ImEvwan/HellkiteOpenSource/-íontroller case/Footing.STEP

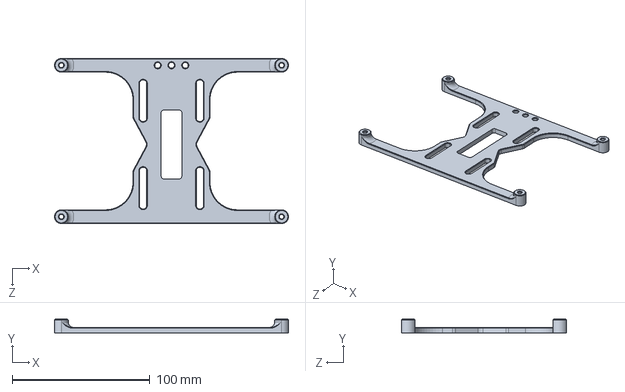
[picture p1: CAD file, 2023-02-28]
-íontroller case/Footing.STEP
170.0 x 10.0 x 120.0 mm
