ImEvwan/HellkiteOpenSource/Deck Protector/Track Protector.STEP

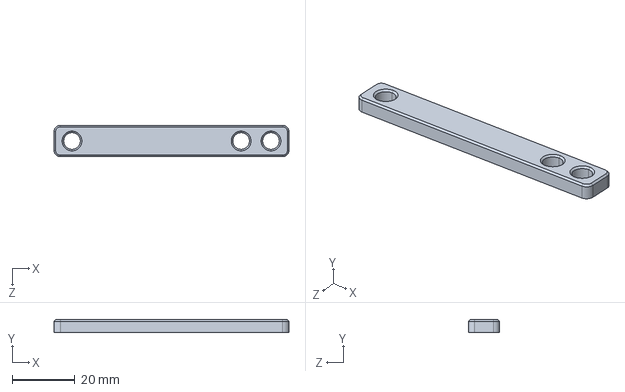
[picture p2: CAD file, 2023-02-28]
Deck Protector/Track Protector.STEP
75.0 x 4.00 x 10.0 mm
