ImEvwan/HellkiteOpenSource/Gear Drive/Drivin gear 19 T.pdf.stp

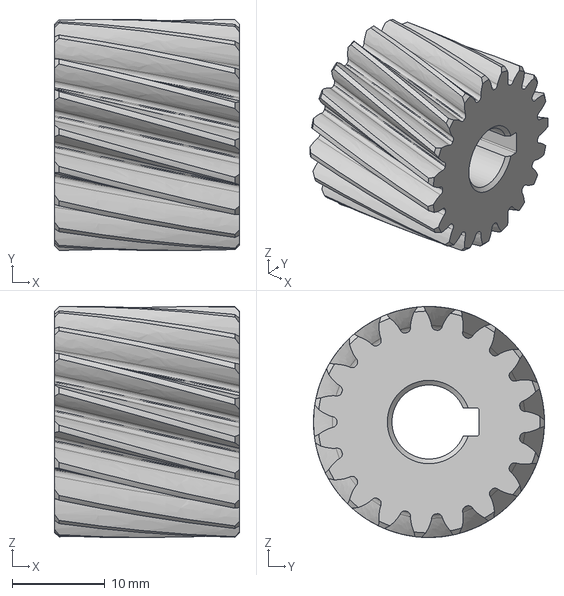
[picture p3: CAD file, 2023-02-28]
Gear Drive/Drivin gear 19 T.pdf.stp
20.0 x 25.0 x 25.0 mm
