ImEvwan/HellkiteOpenSource/Motor mount flipsky/Roller.STEP

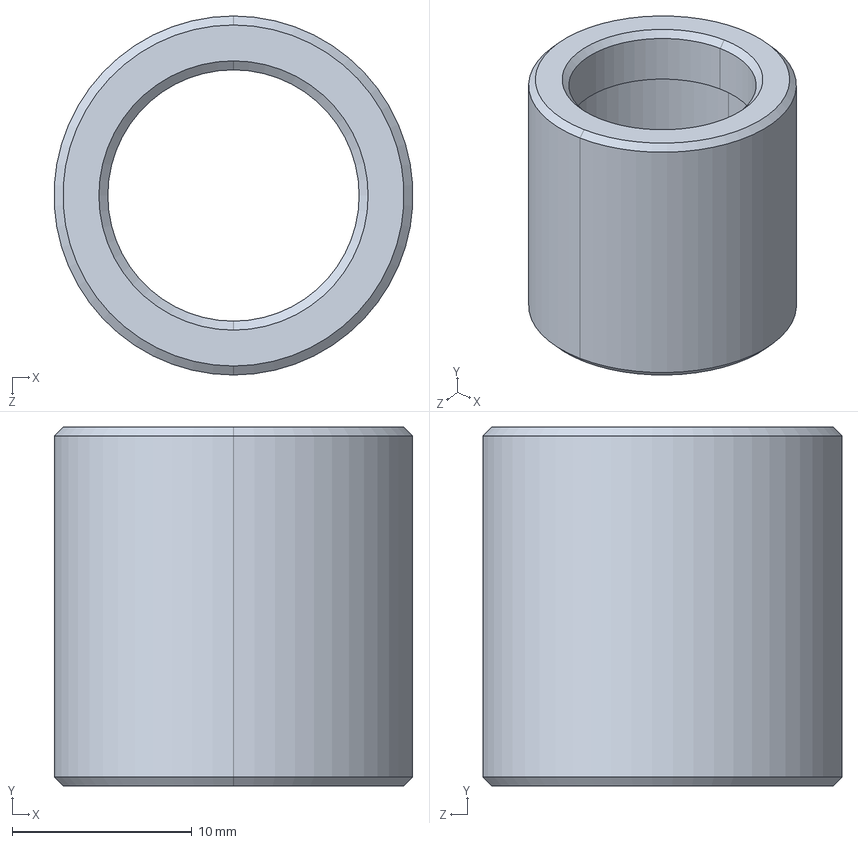
[picture p4: CAD file, 2023-02-28]
Motor mount flipsky/Roller.STEP
20.0 x 20.0 x 20.0 mm
