ImEvwan/HellkiteOpenSource/Motor mount MTB/Roller mount.STEP

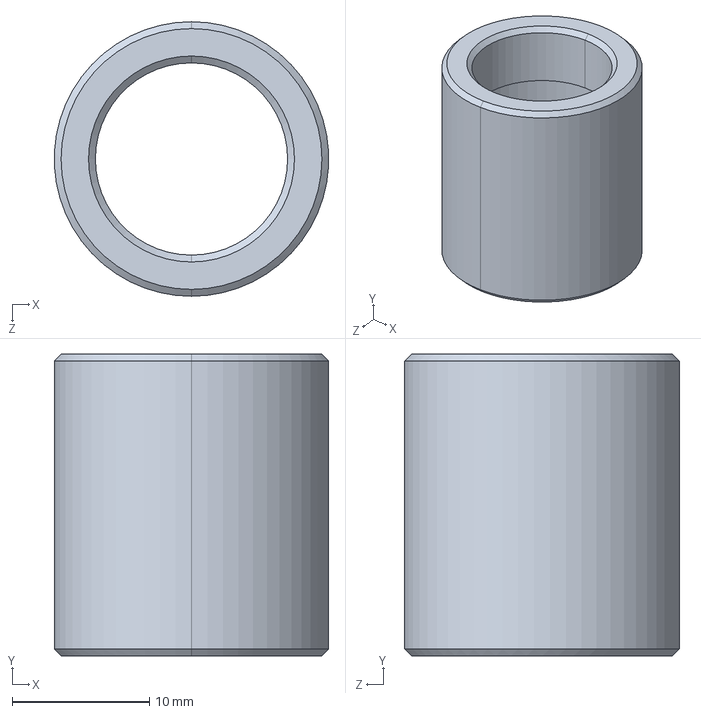
[picture p5: CAD file, 2023-02-28]
Motor mount MTB/Roller mount.STEP
20.0 x 22.0 x 20.0 mm
