ImEvwan/HellkiteOpenSource/Offroad MTB KIT 1/Bracket L.stp

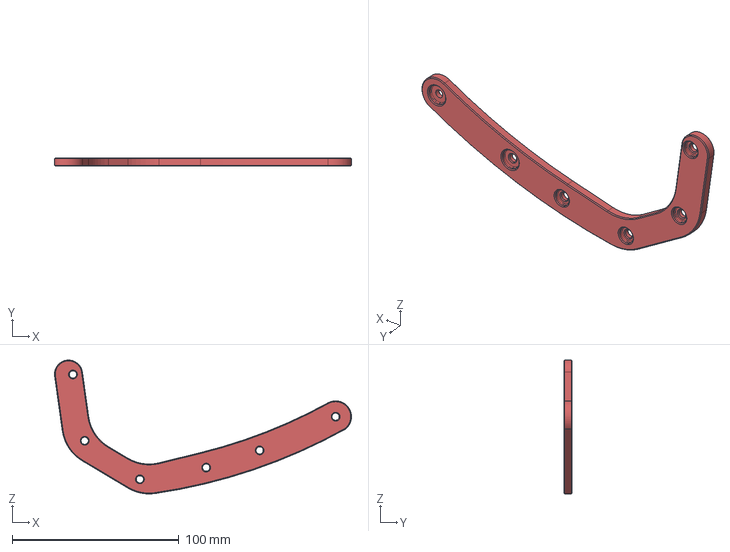
[picture p6: CAD file, 2023-02-28]
Offroad MTB KIT 1/Bracket L.stp
178.1 x 5.00 x 80.3 mm
