ImEvwan/HellkiteOpenSource/Offroad MTB KIT 2/Bashguard.STEP

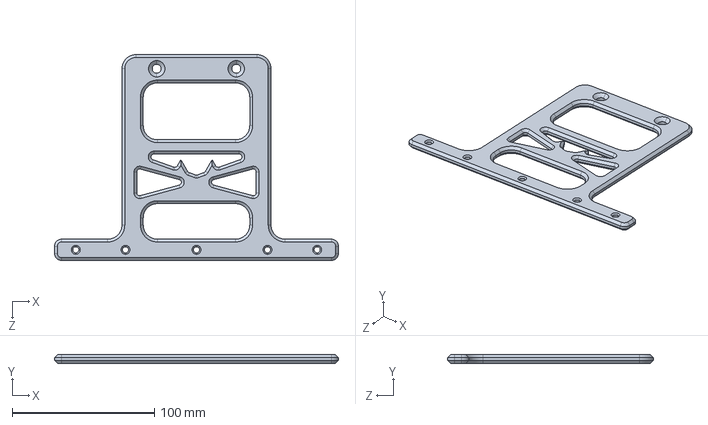
[picture p7: CAD file, 2023-02-28]
Offroad MTB KIT 2/Bashguard.STEP
200.0 x 6.00 x 145.0 mm
