ImEvwan/HellkiteOpenSource/Pulley/Pulley 60T.STEP

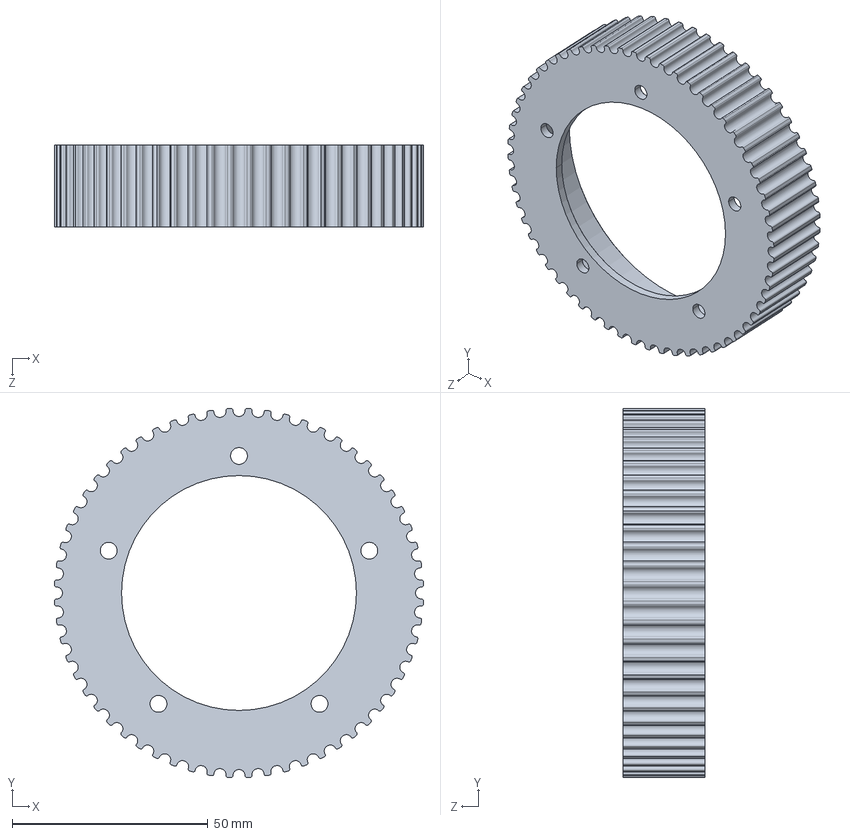
[picture p8: CAD file, 2023-02-28]
Pulley/Pulley 60T.STEP
94.3 x 94.3 x 21.0 mm
