ImEvwan/HellkiteOpenSource/Spacer 40mm/Spacer 40mm.STEP

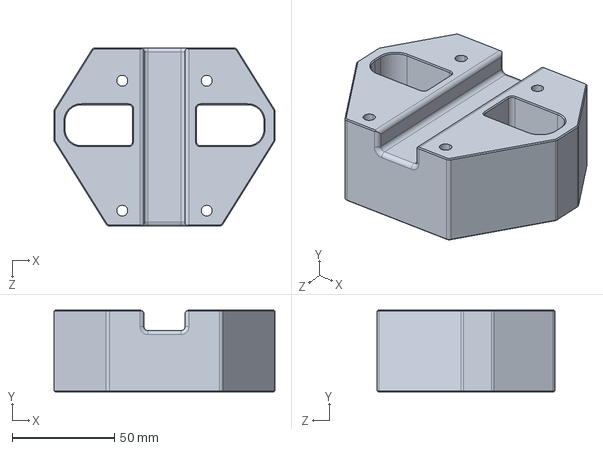
[picture p9: CAD file, 2023-02-28]
Spacer 40mm/Spacer 40mm.STEP
108.0 x 40.0 x 87.0 mm
