ImEvwan/HellkiteOpenSource/Truck/Hanger.stp

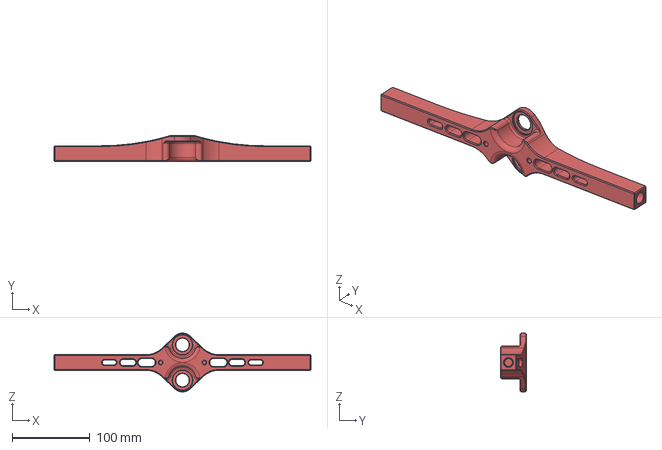
[picture p10: CAD file, 2023-02-28]
Truck/Hanger.stp
330.0 x 33.0 x 75.5 mm
