ImEvwan/HellkiteOpenSource/Wheel/Wheel hub.stp

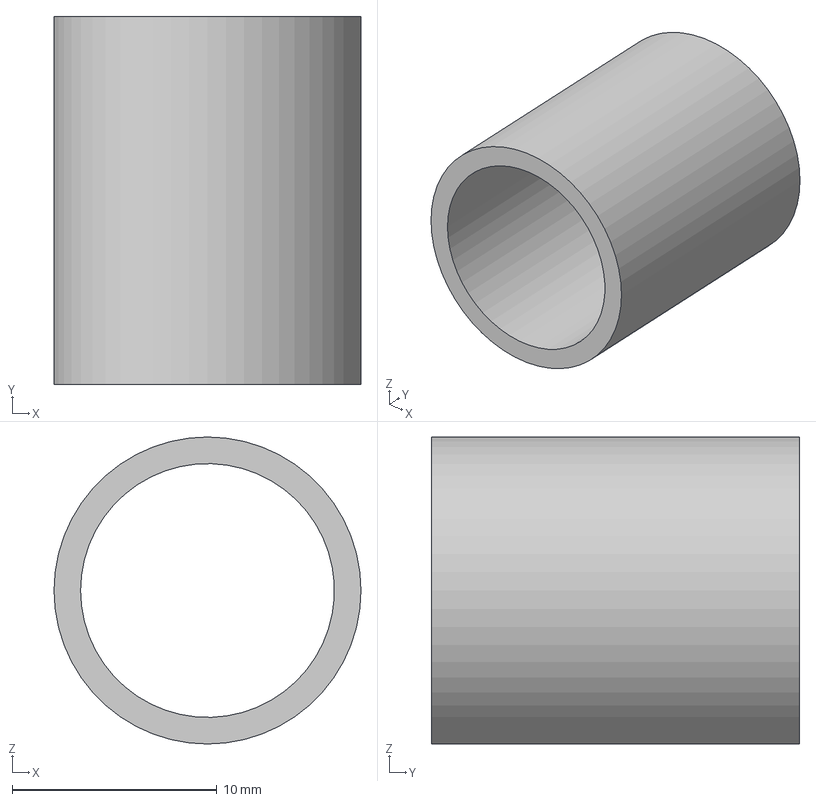
[picture p11: CAD file, 2023-02-28]
Wheel/Wheel hub.stp
15.0 x 18.0 x 15.0 mm
