ImEvwan/HellkiteOpenSource/-íontroller case/Upper half.step

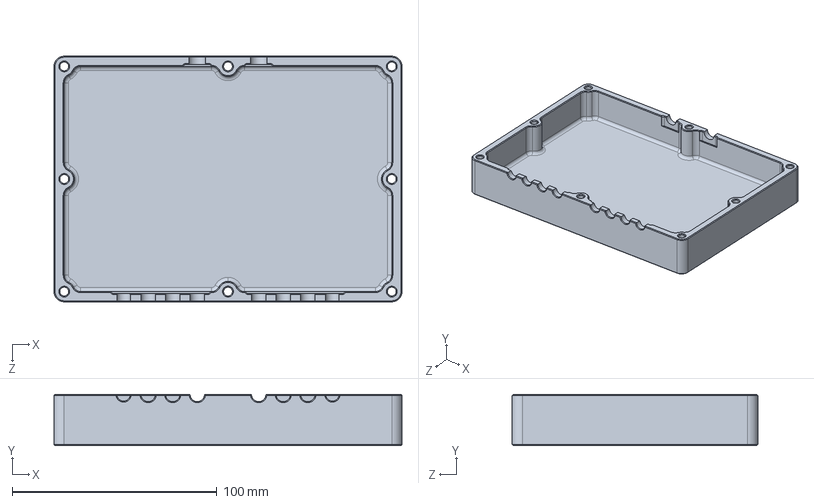
[picture p12: CAD file, 2023-02-28]
-íontroller case/Upper half.step
170.0 x 25.0 x 120.0 mm
