ImEvwan/HellkiteOpenSource/Deck Protector/Deck Protector.STEP

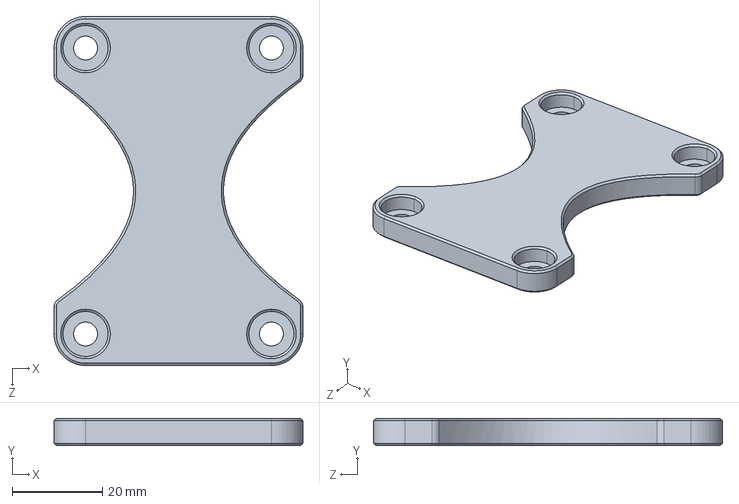
[picture p14: CAD file, 2023-02-28]
Deck Protector/Deck Protector.STEP
55.3 x 6.00 x 77.5 mm
