ImEvwan/HellkiteOpenSource/Gear Drive/Adapter plate.stp

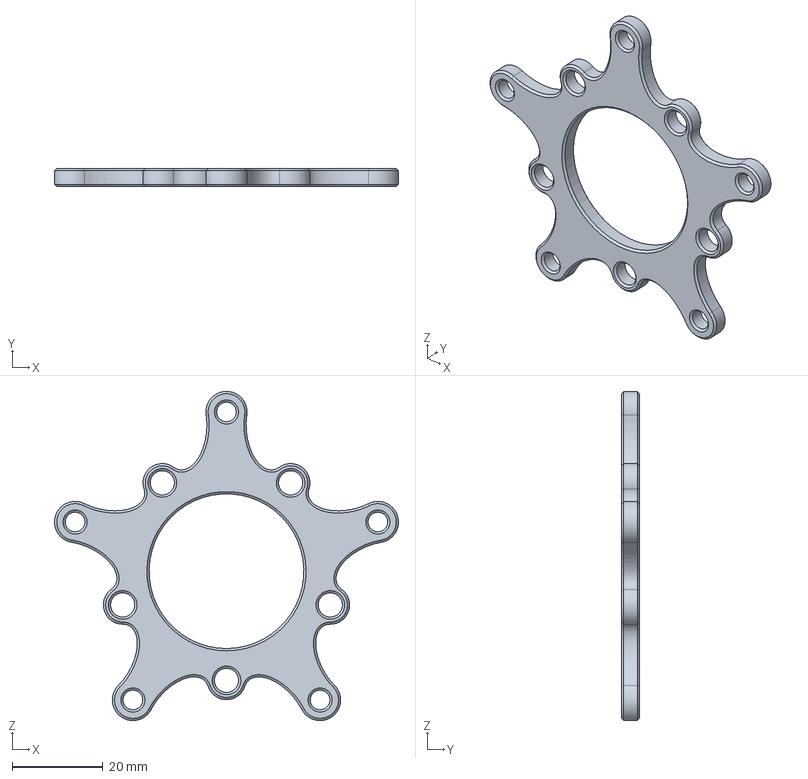
[picture p15: CAD file, 2023-02-28]
Gear Drive/Adapter plate.stp
75.6 x 4.00 x 72.4 mm
