ImEvwan/HellkiteOpenSource/Motor mount flipsky/Motor mount 2.STEP

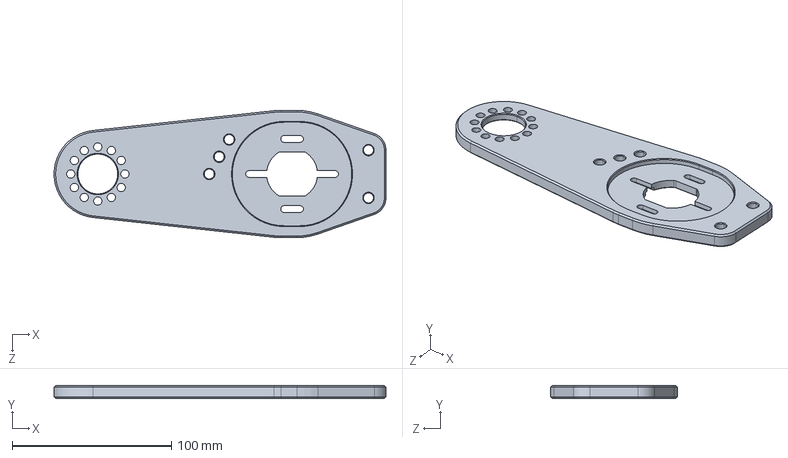
[picture p16: CAD file, 2023-02-28]
Motor mount flipsky/Motor mount 2.STEP
208.5 x 8.00 x 80.0 mm
