ImEvwan/HellkiteOpenSource/Motor mount MTB/Rack MTB.STEP

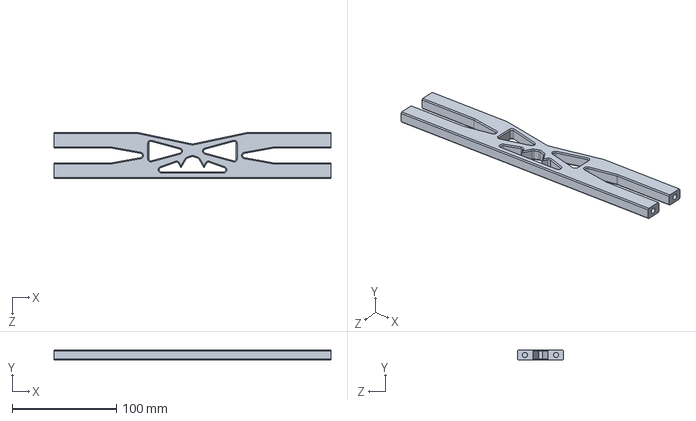
[picture p17: CAD file, 2023-02-28]
Motor mount MTB/Rack MTB.STEP
266.0 x 10.0 x 44.0 mm
