ImEvwan/HellkiteOpenSource/Pulley/Pulley 72-ó.STEP

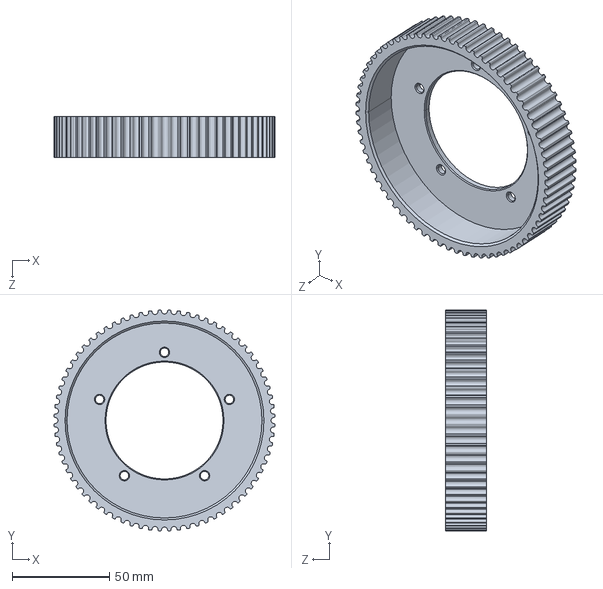
[picture p18: CAD file, 2023-02-28]
Pulley/Pulley 72-ó.STEP
113.4 x 113.4 x 21.0 mm
