ImEvwan/HellkiteOpenSource/Truck/Plate.STEP

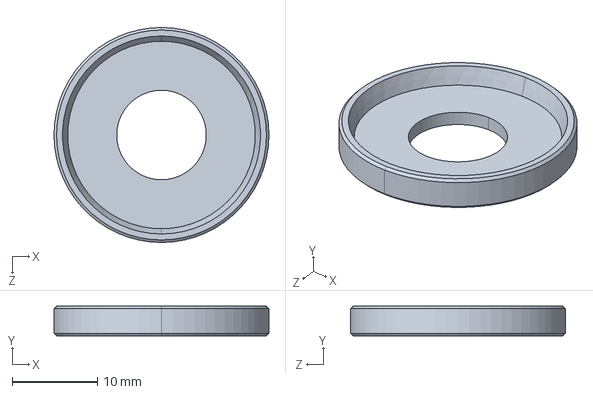
[picture p19: CAD file, 2023-02-28]
Truck/Plate.STEP
25.2 x 3.50 x 25.2 mm
