ImEvwan/HellkiteOpenSource/Wheel/Internal wheel.stp

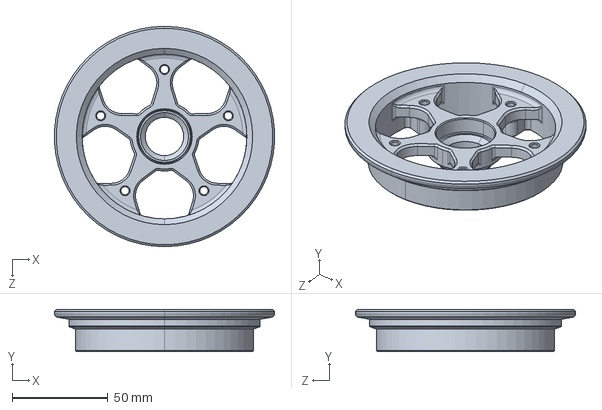
[picture p20: CAD file, 2023-02-28]
Wheel/Internal wheel.stp
114.8 x 22.0 x 115.0 mm
