ImEvwan/HellkiteOpenSource/-íontroller case/Lower half.step

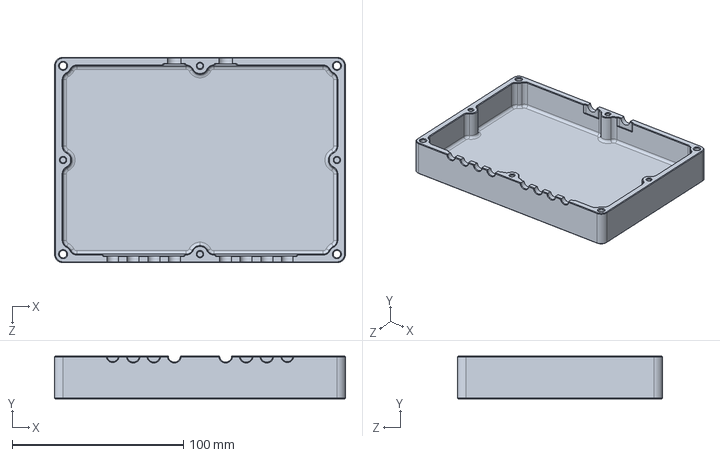
[picture p21: CAD file, 2023-02-28]
-íontroller case/Lower half.step
170.0 x 25.0 x 120.0 mm
