ImEvwan/HellkiteOpenSource/Gear Drive/-íase reducer.stp

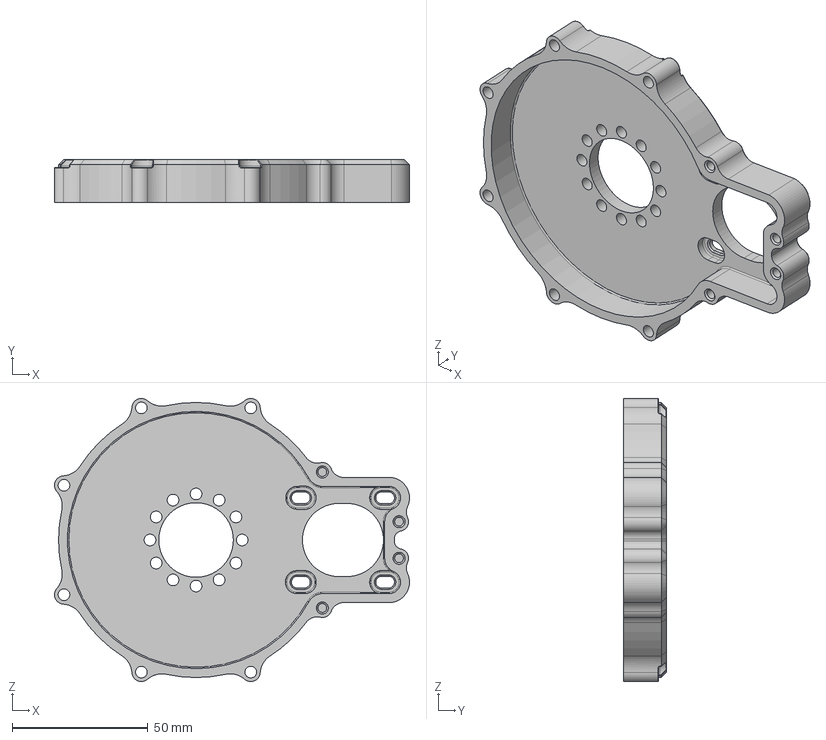
[picture p22: CAD file, 2023-02-28]
Gear Drive/-íase reducer.stp
131.0 x 16.0 x 104.5 mm
