ImEvwan/HellkiteOpenSource/Motor mount MTB/Motor mount MTB 1.STEP

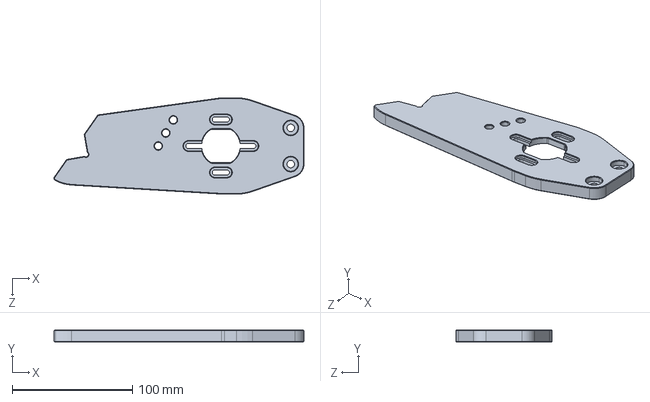
[picture p23: CAD file, 2023-02-28]
Motor mount MTB/Motor mount MTB 1.STEP
207.6 x 10.0 x 80.0 mm
