ImEvwan/HellkiteOpenSource/Offroad MTB KIT 1/Spacer tube.stp

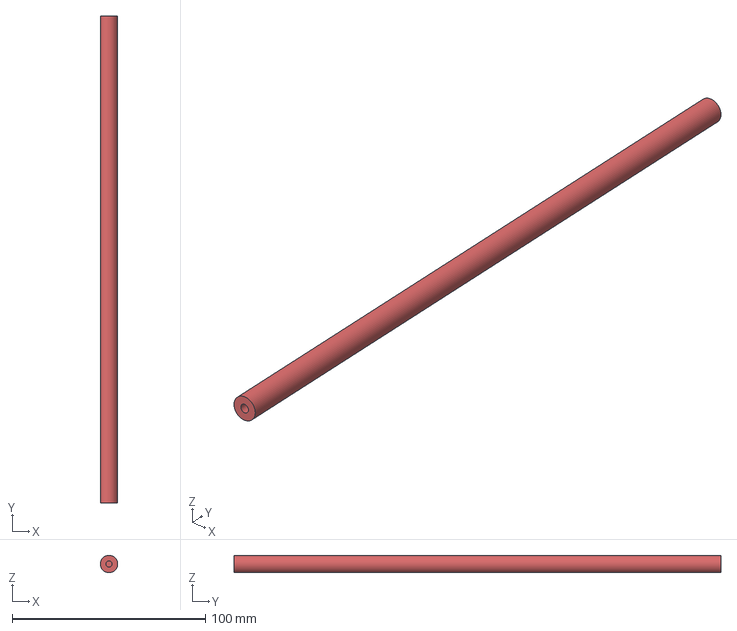
[picture p24: CAD file, 2023-02-28]
Offroad MTB KIT 1/Spacer tube.stp
8.99 x 252.0 x 9.00 mm
