ImEvwan/HellkiteOpenSource/Pulley/Pulley Spacer.STEP

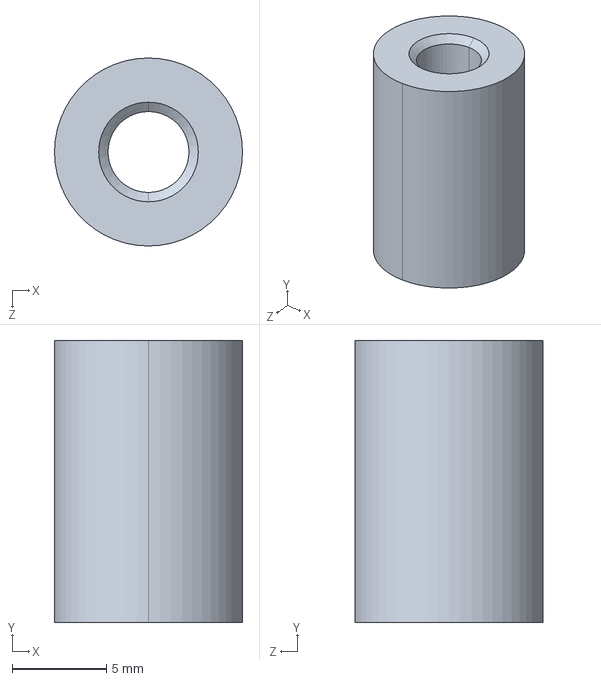
[picture p25: CAD file, 2023-02-28]
Pulley/Pulley Spacer.STEP
10.00 x 15.0 x 10.00 mm
