ImEvwan/HellkiteOpenSource/Wheel/External wheel.stp

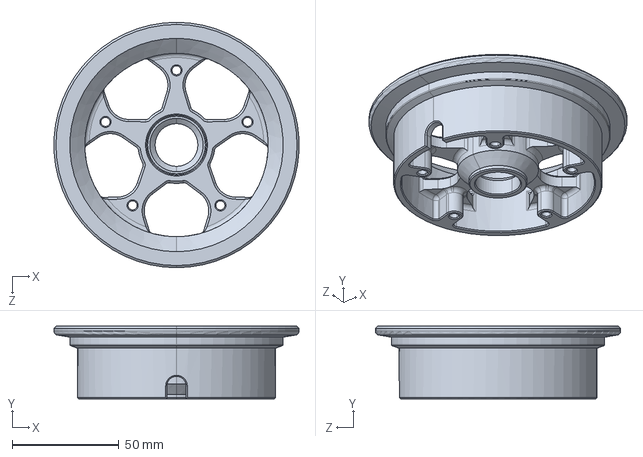
[picture p26: CAD file, 2023-02-28]
Wheel/External wheel.stp
114.8 x 34.0 x 115.0 mm
