ImEvwan/HellkiteOpenSource/Gear Drive/-íover reducer.stp

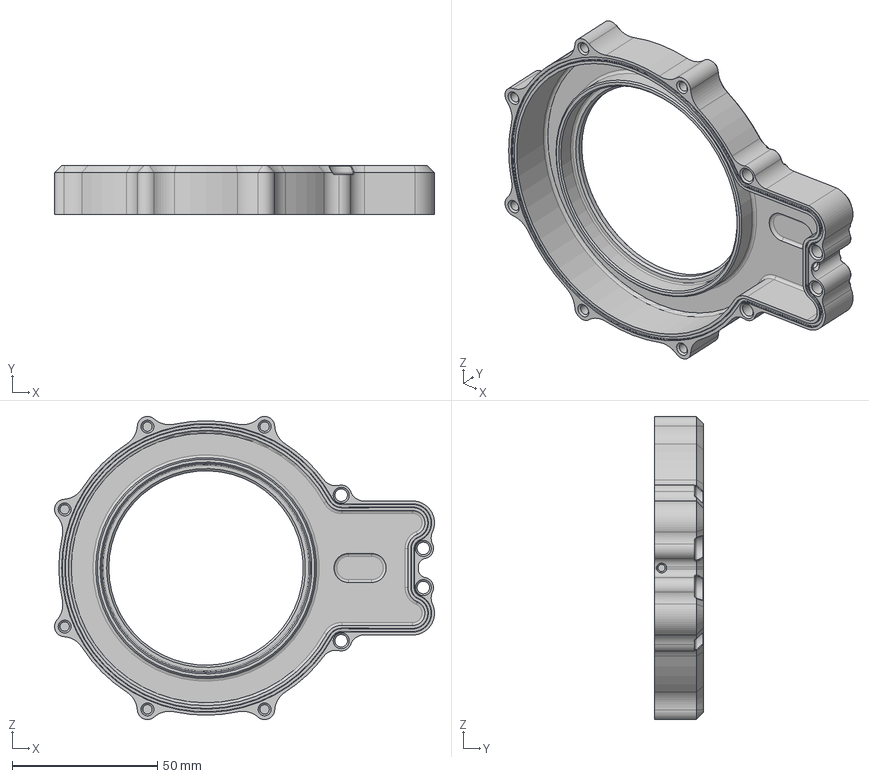
[picture p27: CAD file, 2023-02-28]
Gear Drive/-íover reducer.stp
131.0 x 17.0 x 104.5 mm
