ImEvwan/HellkiteOpenSource/Motor mount flipsky/Rack.STEP

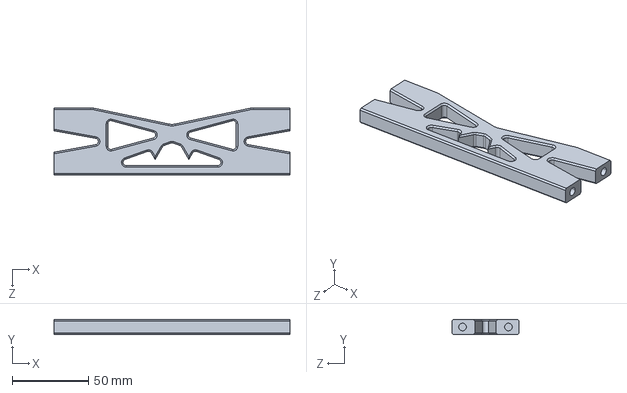
[picture p28: CAD file, 2023-02-28]
Motor mount flipsky/Rack.STEP
154.3 x 10.0 x 44.0 mm
