ImEvwan/HellkiteOpenSource/Motor mount MTB/Stopper mount.STEP

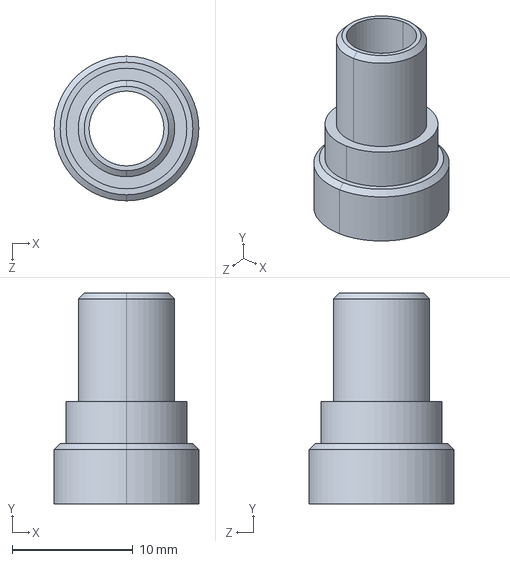
[picture p29: CAD file, 2023-02-28]
Motor mount MTB/Stopper mount.STEP
12.0 x 17.5 x 12.0 mm
