ImEvwan/HellkiteOpenSource/Truck/Axle.stp

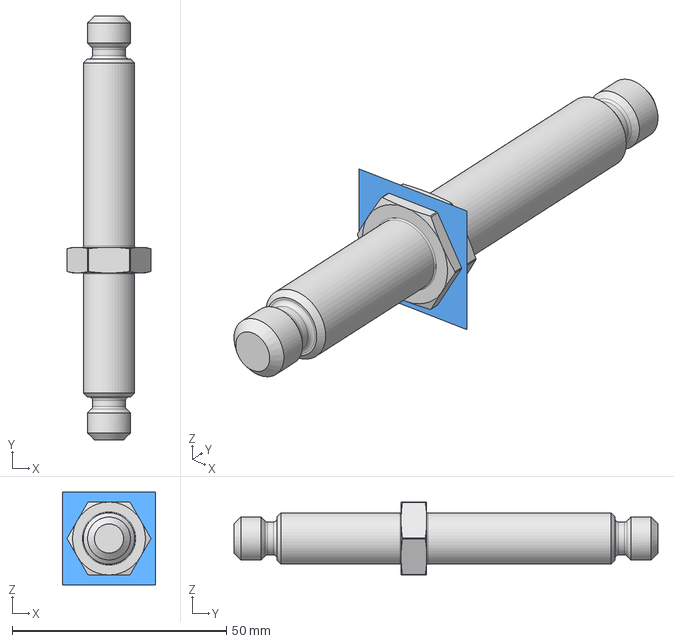
[picture p30: CAD file, 2023-02-28]
Truck/Axle.stp
21.6 x 99.0 x 21.6 mm
