ImEvwan/HellkiteOpenSource/Gear Drive/Reducer mounting sleeve.stp

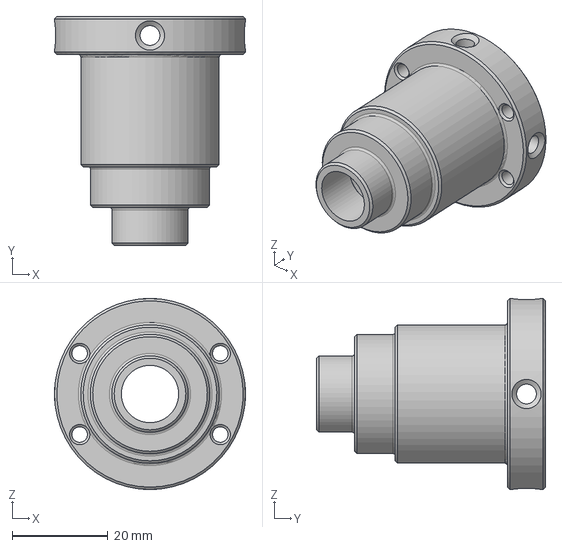
[picture p31: CAD file, 2023-02-28]
Gear Drive/Reducer mounting sleeve.stp
40.0 x 48.0 x 40.0 mm
