ImEvwan/HellkiteOpenSource/Motor mount flipsky/Stopper.STEP

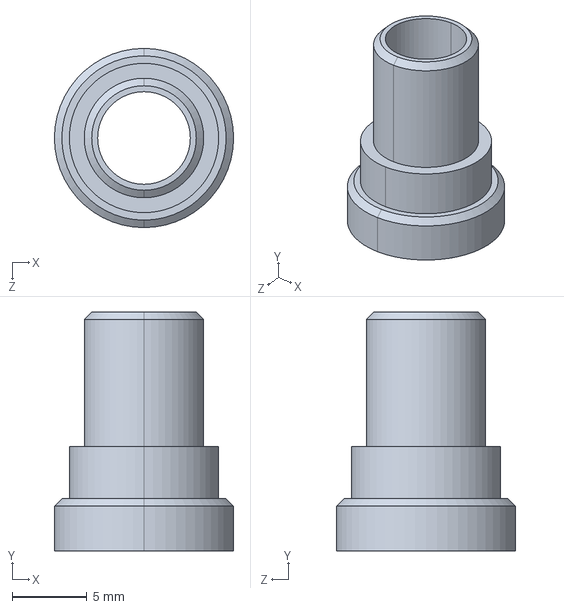
[picture p32: CAD file, 2023-02-28]
Motor mount flipsky/Stopper.STEP
12.0 x 16.0 x 12.0 mm
