ImEvwan/HellkiteOpenSource/Truck/Platform.STEP

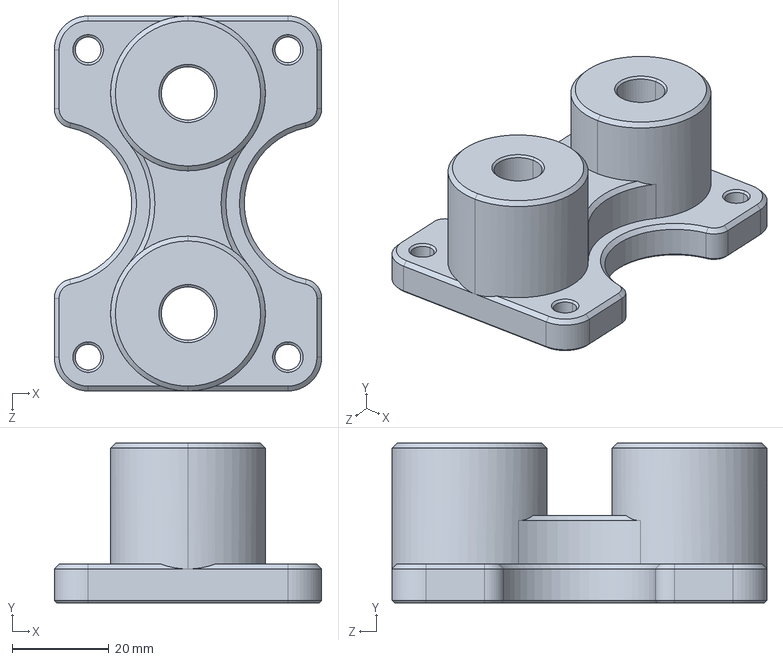
[picture p33: CAD file, 2023-02-28]
Truck/Platform.STEP
55.3 x 33.0 x 77.5 mm
