ImEvwan/HellkiteOpenSource/Gear Drive/Drivin gear 14 T.stp

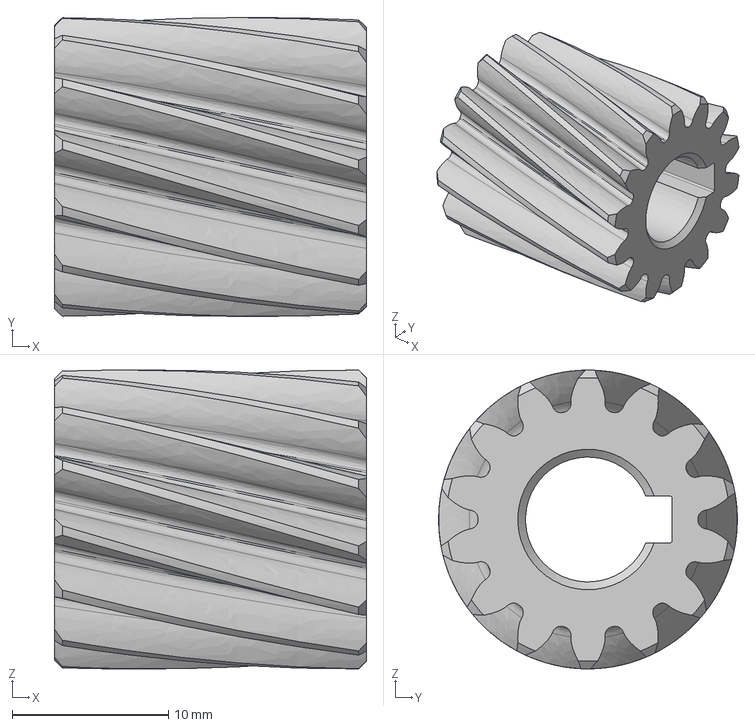
[picture p34: CAD file, 2023-02-28]
Gear Drive/Drivin gear 14 T.stp
20.0 x 19.2 x 19.2 mm
