ImEvwan/HellkiteOpenSource/Motor mount MTB/Motor mount Clamp.STEP

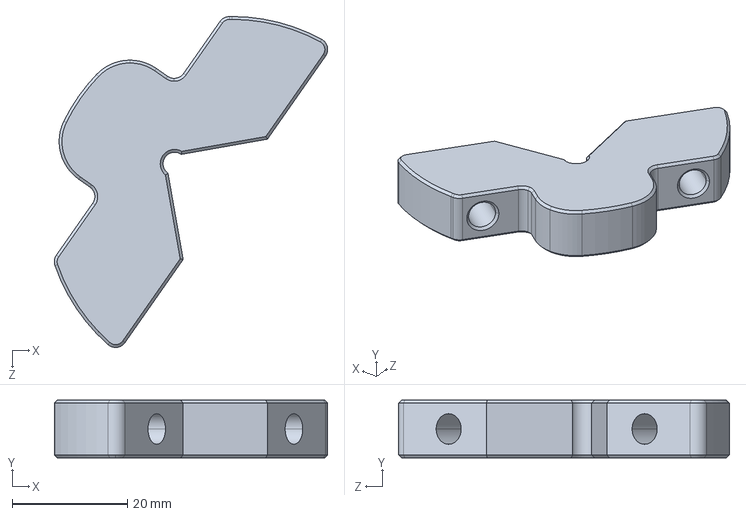
[picture p35: CAD file, 2023-02-28]
Motor mount MTB/Motor mount Clamp.STEP
47.4 x 10.0 x 57.4 mm
