ImEvwan/HellkiteOpenSource/Truck/Sleeve for Trampa.STEP

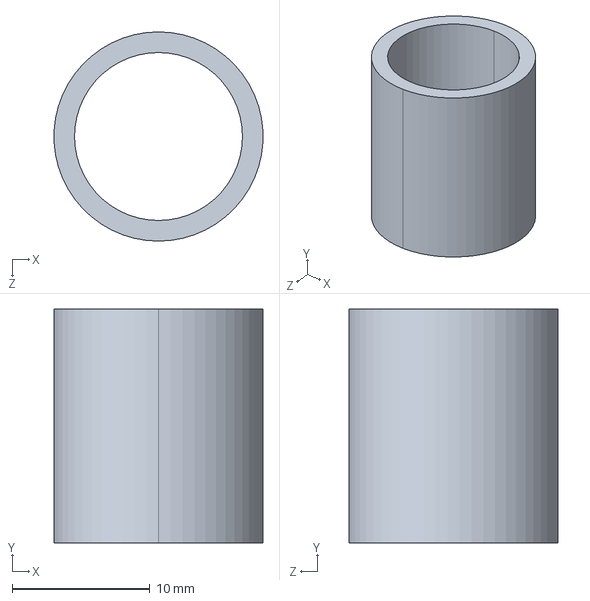
[picture p36: CAD file, 2023-02-28]
Truck/Sleeve for Trampa.STEP
15.2 x 17.0 x 15.2 mm
