ImEvwan/HellkiteOpenSource/(list of files, cad)

Other CAD files:
Offroad MTB KIT 1/Bracket R.stp
Motor mount flipsky/Motor mount 1.STEP
Motor mount MTB/Motor mount MTB 2.STEP
Bushing matrix/Screw for the bushing matrix.stp
