ImEvwan/HellkiteOpenSource/Motor mount MTB/Roller mount.pdf

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

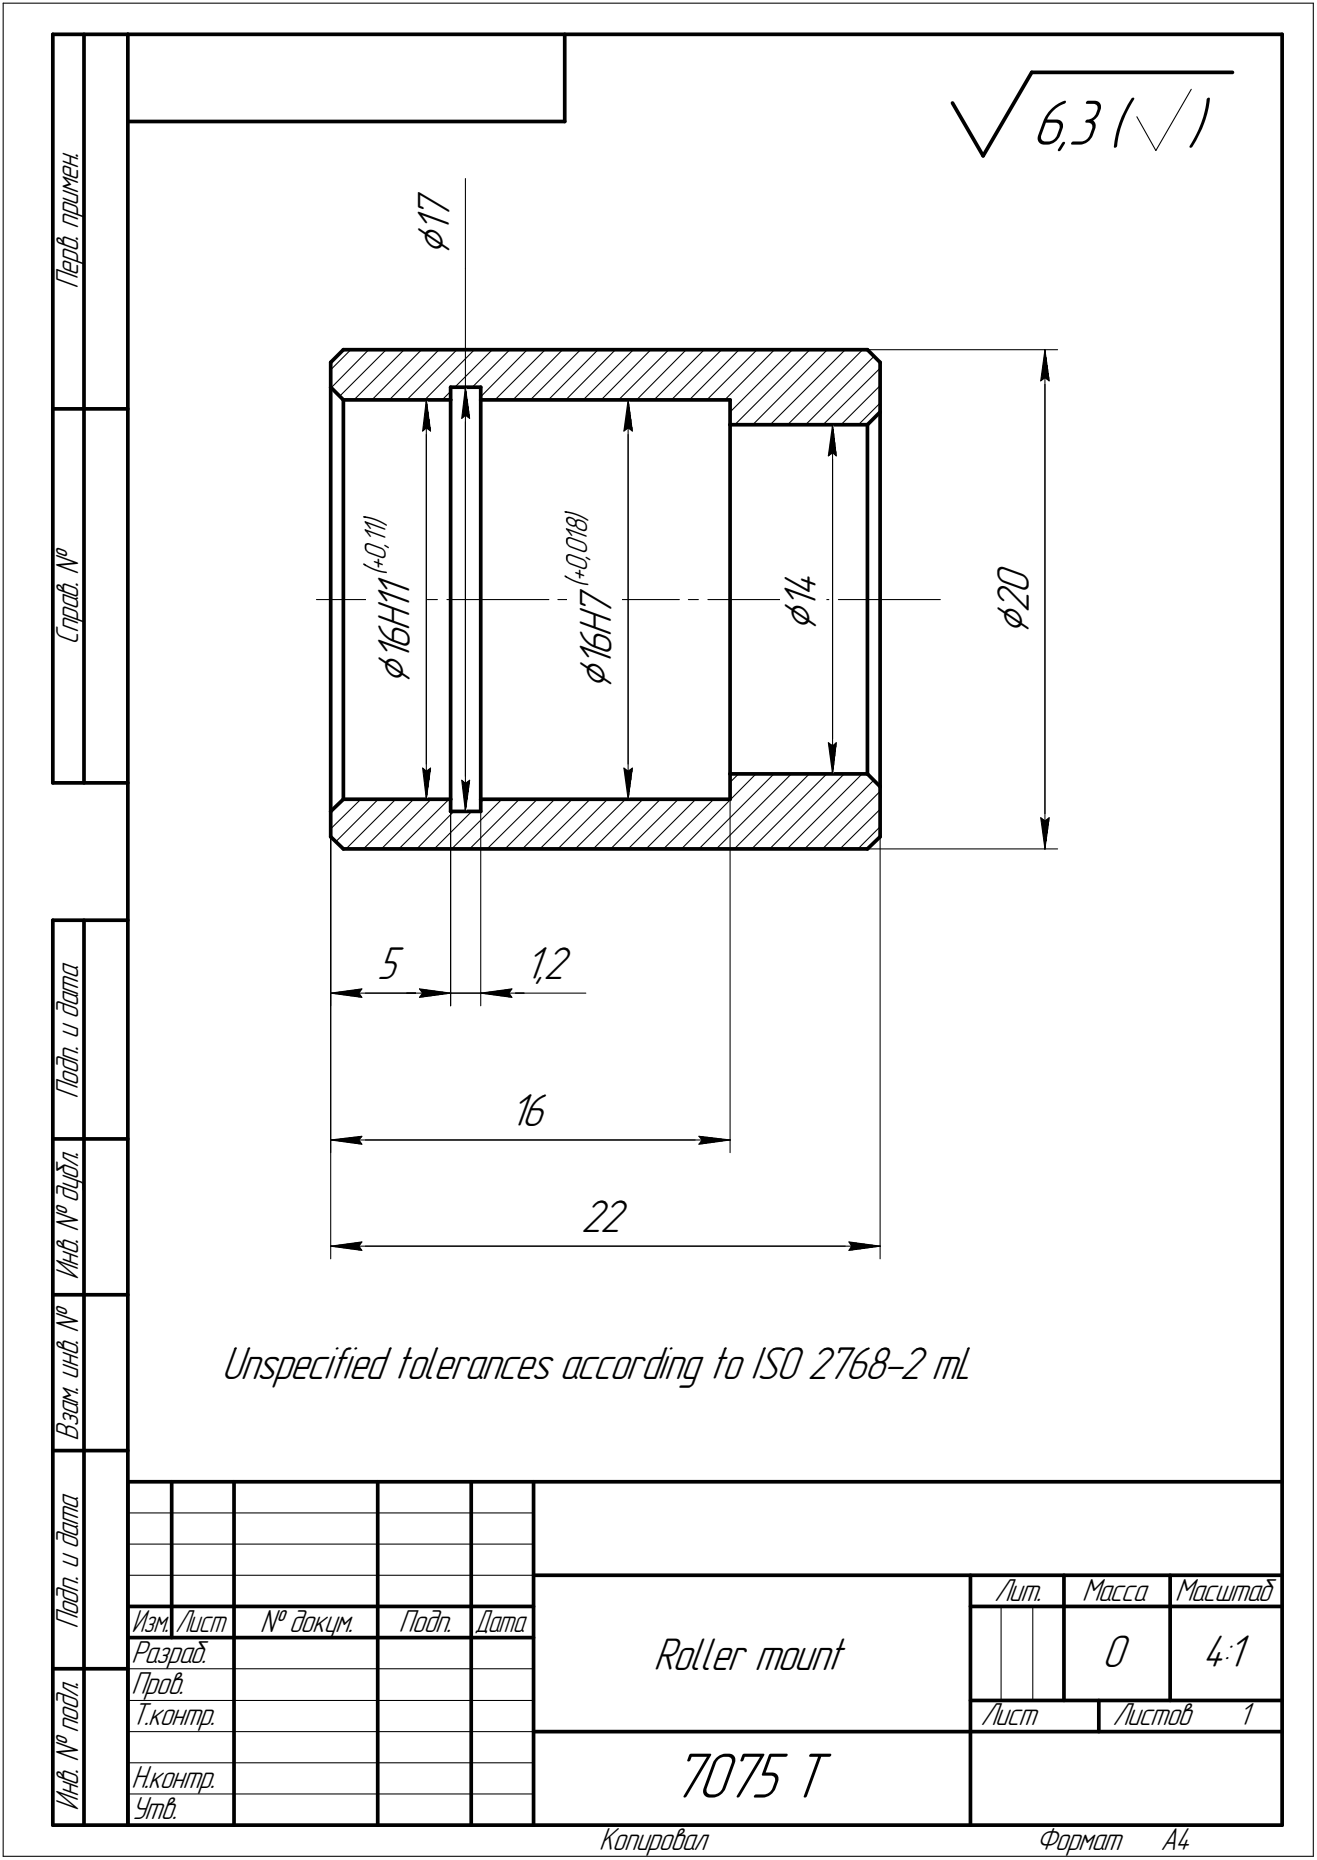
[picture p52: page 1]
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
